KoljaWindeler/CHIP_TZATZIFFY/documentation/solder_SD.png

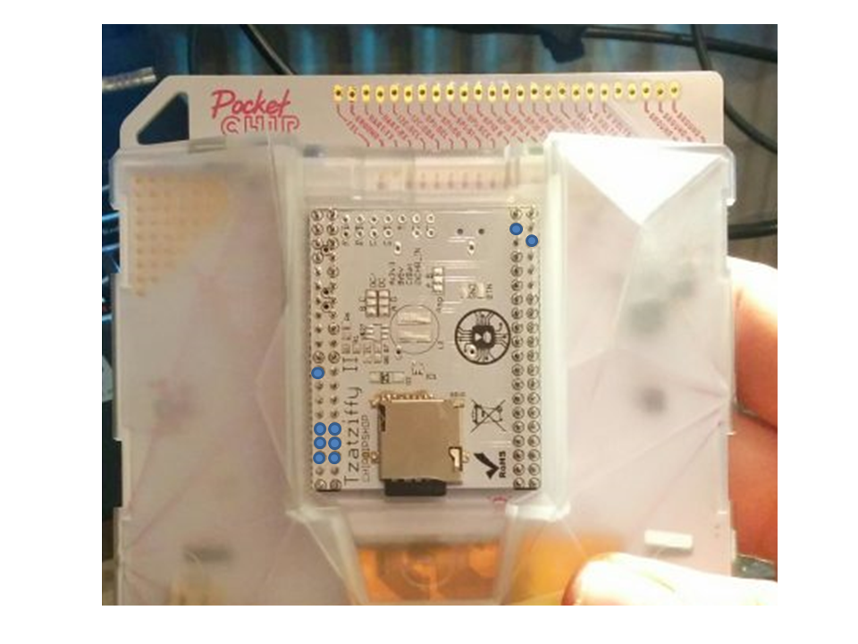
documentation/solder_SD.png
