KoljaWindeler/CHIP_TZATZIFFY/schematic/v6/CHIP_tzatziffy_v6.csv

Part | Value | Device | Package | Description | ASSEMBLE | DESCRIPTION | FOOTPRINT | LINK | MFG | MFG_PN | PART_TYPE | PRICE | TOLLERANCE | VALUE | VENDOR | VENDOR_PART_NUMBER
C1 | 220pF | C-EUC0805 | C0805 | CAPACITOR, European symbol
C2 | 100nF | C-EUC0805 | C0805 | CAPACITOR, European symbol
C3 | 100nF | C-EUC0805 | C0805 | CAPACITOR, European symbol
C4 | 22uF | C-EUC0805 | C0805 | CAPACITOR, European symbol
C5 | 22uF | C-EUC0805 | C0805 | CAPACITOR, European symbol
C6 | 100nF | C-EUC0805 | C0805 | CAPACITOR, European symbol
C7 | n.a. | C-EUC0805 | C0805 | CAPACITOR, European symbol
C8 | 100nF | C-EUC0805 | C0805 | CAPACITOR, European symbol
C9 | 100nF | C-EUC0805 | C0805 | CAPACITOR, European symbol
C10 | n.a. | C-EUC0805 | C0805 | CAPACITOR, European symbol
C11 | 1uF | C-EUC0805 | C0805 | CAPACITOR, European symbol
C12 | 1uF | C-EUC0805 | C0805 | CAPACITOR, European symbol
C13 | 470nF | C-EUC0805 | C0805 | CAPACITOR, European symbol
C14 | 470nF | C-EUC0805 | C0805 | CAPACITOR, European symbol
C15 | 1uF | C-EUC0805 | C0805 | CAPACITOR, European symbol
D1 | B240A | DIODE_SCHTKY_B240 | DO-214AC |  |  | DIODE SMD General Purpose 400V 1A 1.4W RoHS DO-214AC | DO-214AC | http://www.digikey.com/product-detail/en/B240A-13-F/B240A-FDICT-ND/717810 | DIGIKEY | B240A-FDICT-ND | DIODE | 0.11 |  | B240A | DIODES | B240A-13-F
J1 | 2X20-CHIP0.8_DRILL | 2X20-CHIP0.8_DRILL | 2X20CHIP_NOOFFSET-TH_0.8 | Through hole layout with chip reference
J3 | S2B-PH-SM4-TB | S2B-PH-SM4-TB | S2B-PH-SM4-TB |  |  | 2 pin con, 2MM RA, SMD | S2B-PH-SM4-TB | http://www.digikey.com/product-detail/en/S2B-PH-SM4-TB(LF)(SN)/455-1749-1-ND/926846 | DIGIKEY | 455-1749-1-ND | CON | 0.26 |  |  | JST | S2B-PH-SM4-TB(LF)(SN)
L+ | LSP10 | LSP10 | LSP10 | SOLDER PAD drill 1.0 mm, distributor Buerklin, 12H555
L- | LSP10 | LSP10 | LSP10 | SOLDER PAD drill 1.0 mm, distributor Buerklin, 12H555
L1 | SRN6045-100M | SRN6045-100M | SRN6045 |  |  | power inductor 10uH 2.5A 58.6 mohm | SRN6045 | http://www.digikey.com/product-detail/en/SRN6045-100M/SRN6045-100MTR-ND/2756120 | DIGIKEY | SRN6045-100MTR-ND | IND | 0.15 | ±20% |  | BOURNS | SRN6045-100M
L2 | SRN6045-100M | SRN6045-100M | SRN6045 |  |  | power inductor 10uH 2.5A 58.6 mohm | SRN6045 | http://www.digikey.com/product-detail/en/SRN6045-100M/SRN6045-100MTR-ND/2756120 | DIGIKEY | SRN6045-100MTR-ND | IND | 0.15 | ±20% |  | BOURNS | SRN6045-100M
LG | LSP10 | LSP10 | LSP10 | SOLDER PAD drill 1.0 mm, distributor Buerklin, 12H555
LI | LSP10 | LSP10 | LSP10 | SOLDER PAD drill 1.0 mm, distributor Buerklin, 12H555
LO | LSP10 | LSP10 | LSP10 | SOLDER PAD drill 1.0 mm, distributor Buerklin, 12H555
PAM1 |  | PAM8403 | SOP-16 | Dual channel audio amplifier IC - PAM8403
Q1 | NPN-DTC114YUA | NPN-DTC114YUA | SOT323
Q2 | PNP-DTA114YUA | PNP-DTA114YUA | SOT323
R+ | LSP10 | LSP10 | LSP10 | SOLDER PAD drill 1.0 mm, distributor Buerklin, 12H555
R- | LSP10 | LSP10 | LSP10 | SOLDER PAD drill 1.0 mm, distributor Buerklin, 12H555
R1 | 100K | R-EU_M0805 | M0805 | RESISTOR, European symbol
R2 | 31.6k | R-EU_M0805 | M0805 | RESISTOR, European symbol
R3 | 2.21k | R-EU_M0805 | M0805 | RESISTOR, European symbol
R4 | 10k | R-EU_R0805 | R0805 | RESISTOR, European symbol
R5 | 10k | R-EU_R0805 | R0805 | RESISTOR, European symbol
R12 | 4.7K | R-EU_M0805 | M0805 | RESISTOR, European symbol
R13 | 1.2K | R-EU_M0805 | M0805 | RESISTOR, European symbol
RG | LSP10 | LSP10 | LSP10 | SOLDER PAD drill 1.0 mm, distributor Buerklin, 12H555
RI | LSP10 | LSP10 | LSP10 | SOLDER PAD drill 1.0 mm, distributor Buerklin, 12H555
RO | LSP10 | LSP10 | LSP10 | SOLDER PAD drill 1.0 mm, distributor Buerklin, 12H555
SDIO | TF-HOLDER | TF-HOLDER | TF-PULL | TF / Micro SD socket is PUSH-PUSH type, the card can be pushed into and auto locked and pushed out by simply press the card.
SJ1 |  | SOLDERJUMPER_2WAYT | SJ_2 | Solder Jumper
U$2 | LOGO_10X10_SILK | LOGO_10X10_SILK | LOGO2_10X10_SILK
U$3 | LOGO_NO_TRASHROHS | LOGO_NO_TRASHROHS | LOGO_ROHS_SYM
U$4 | LOGO_NO_TRASHNO_TRASH | LOGO_NO_TRASHNO_TRASH | LOGO_ROHS_NO_TRASH
U$5 | LOGO_10X10_SILK | LOGO_10X10_SILK | LOGO2_10X10_SILK
U1 | LMR62421 | LMR62421 | SOT23-5 |  |  | dc/dc step up, 2.1A, 1.6mhz, SOT-23-5 | SOT23-5 | http://www.digikey.com/product-detail/en/LMR62421XMFE%2FNOPB/LMR62421XMFE%2FNOPBCT-ND/2777085 | DIGIKEY | LMR62421XMFE/NOPBCT-ND | IC | 0.8 |  |  | TEXAS INSTRUMENTS | LMR62421XMFE/NOPB
U3 | DS2431P | DS2431P | TSOC6 | 1024-Bit EEPROM |  | IC, 1024-Bit, 1-Wire EEPROM, TSOC6 | TSOC6 | http://www.digikey.com/product-detail/en/DS2431P%2BT%26R/DS2431P%2BT%26RCT-ND/3647900 | DIGIKEY | DS2431P+T&RCT-ND | IC | 0.98 |  |  | MAXIM | DS2431P+T&R
X1 | FH12-40S-0.5SH | FH12-40S-0.5SH | FH12-40S-0.5SH | 0.5mm Pitch Connectors For FPC/FFC |  | CON ffc smd, bottom contact 40pos, 0.50mm R/A | FH12-40S-0.5SH | http://www.digikey.com/product-detail/en/FH12-40S-0.5SH(55)/HFJ140CT-ND/1110388 | DIGIKEY | HFJ140CT-ND |  |  |  |  | HIROSE | FH12-40S-0.5SH(55)
