KoljaWindeler/CHIP_TZATZIFFY/schematic/v9_ordered/CHIP_tzatziffy_v9.pdf

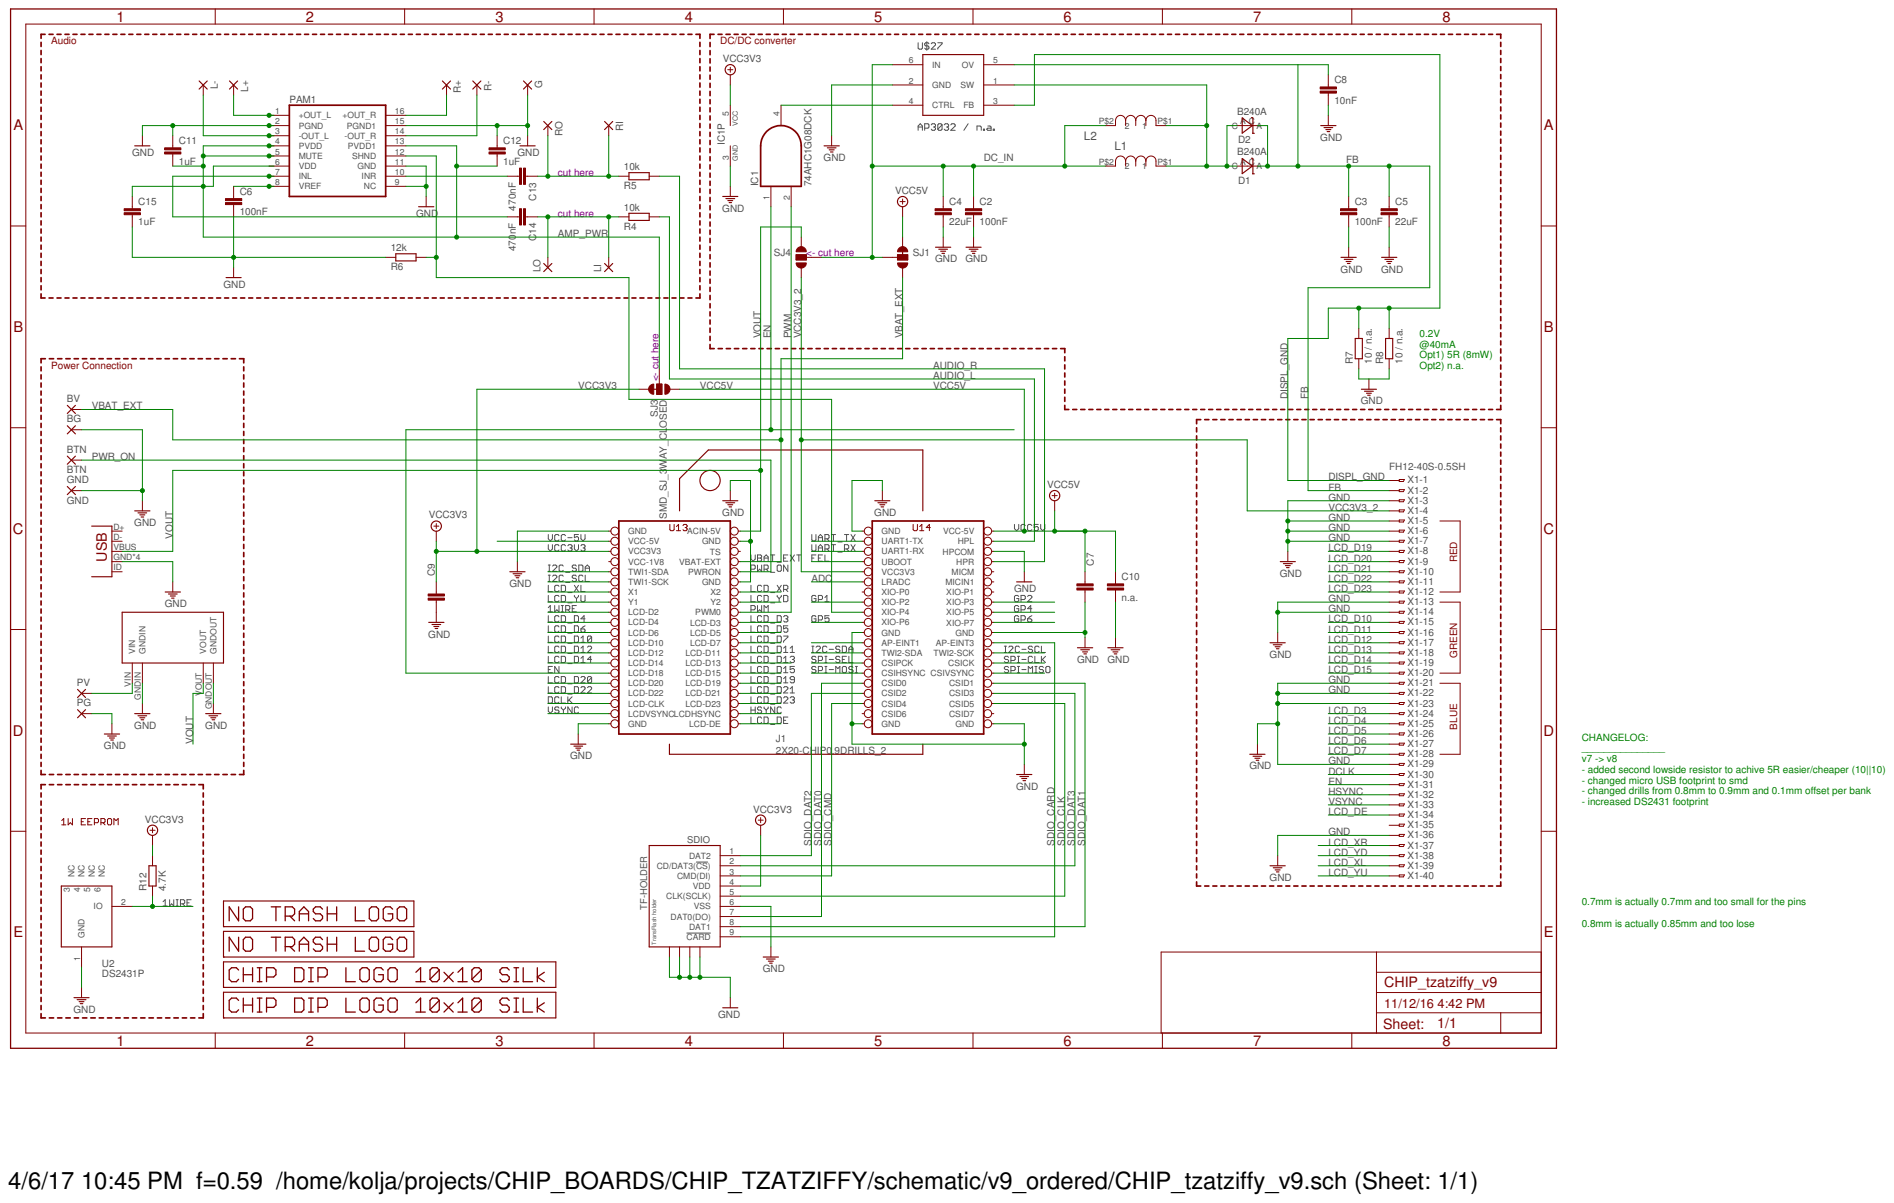
[picture p2: page 1]

<- cut here TransFlash holder

VOUT VOUT GNDOUT GNDOUT

CHANGELOG: _______________
- added second lowside resistor to achive 5R easier/cheaper (10||10)
- changed micro USB footprint to smd
- changed drills from 0.8mm to 0.9mm and 0.1mm offset per bank
- increased DS2431 footprint

0.7mm is actually 0.7mm and too small for the pins 0.8mm is actually 0.85mm and too lose

4/6/17 10:45 PM f=0.59 /home/kolja/projects/CHIP_BOARDS/CHIP_TZATZIFFY/schematic/v9_ordered/CHIP_tzatziffy_v9.sch (Sheet: 1/1)
