KoljaWindeler/CHIP_TZATZIFFY/schematic/v9_ordered/CHIP_tzatziffy_v9_bot.pdf

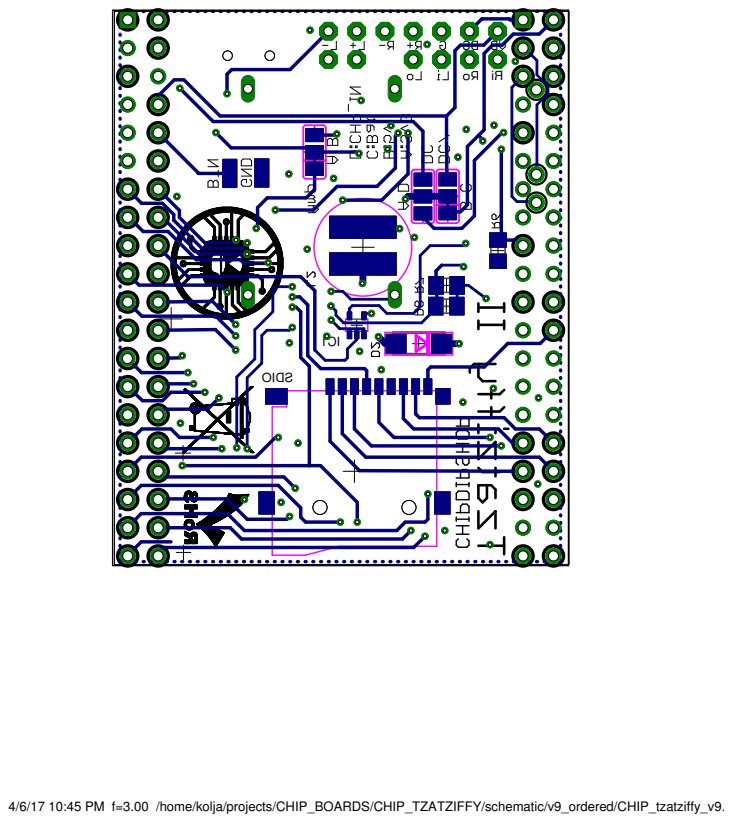
[picture p3: page 1]

4/6/17 10:45 PM f=3.00 /home/kolja/projects/CHIP_BOARDS/CHIP_TZATZIFFY/schematic/v9_ordered/CHIP_tzatziffy_v9.brd
