KoljaWindeler/CHIP_TZATZIFFY/schematic/v9_ordered/CHIP_tzatziffy_v9.brd

## EAGLE design schematic/v9_ordered/CHIP_tzatziffy_v9.brd (2016-11-10)

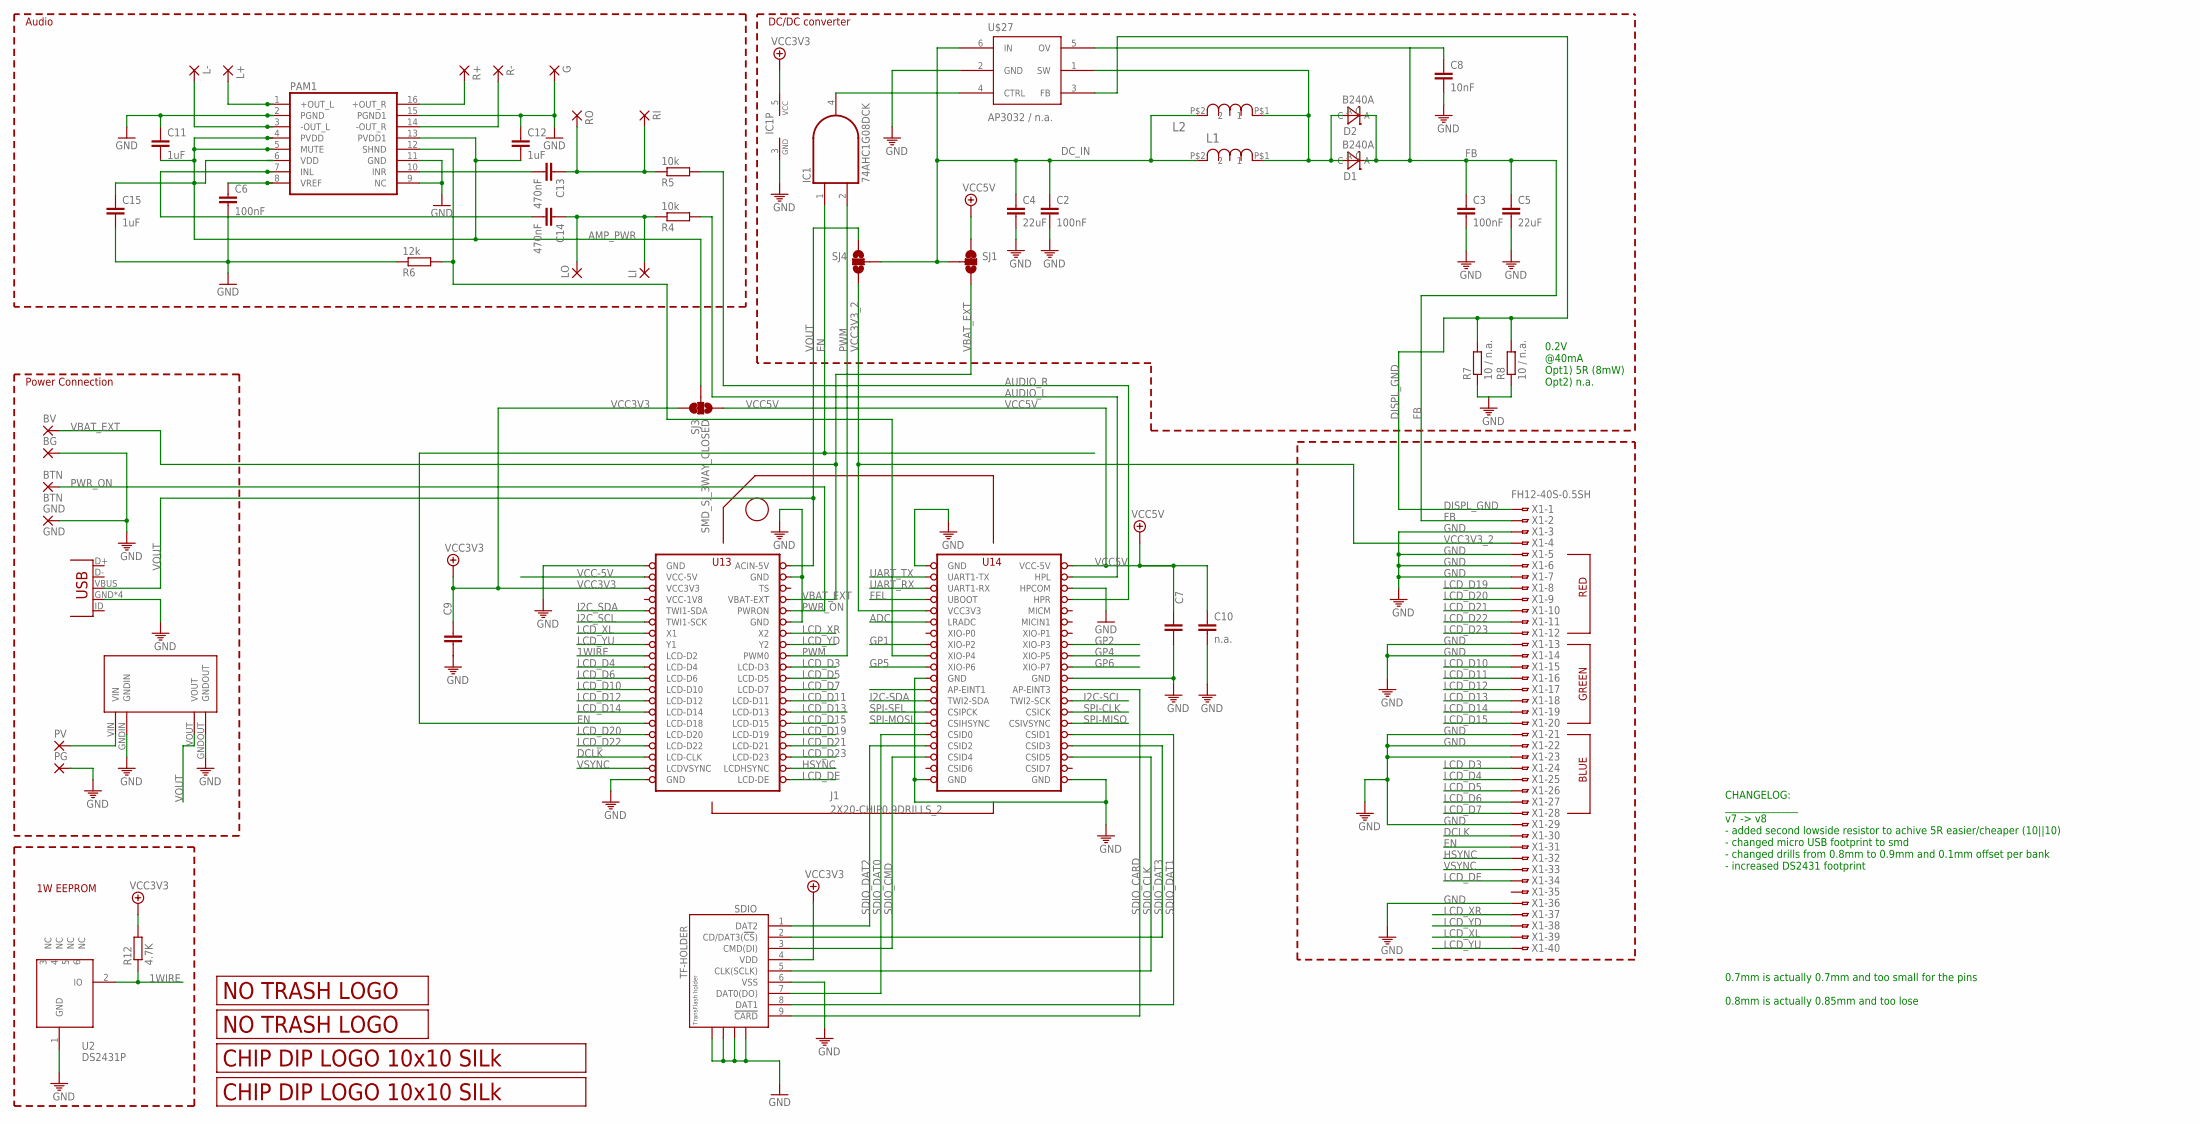
[picture p4: schematic CHIP_tzatziffy_v9.sch]

Parts:
BG: 1,6/0,8
BTN: BTN; SMD1,27-2,54
BV: 1,6/0,8
C2, C3, C6: 100nF; C0805
C4, C5: 22uF; C1206
C7, C9, C10: n.a.; C0805
C8: 10nF; C0805
C11, C12, C15: 1uF; C0805
C13, C14: 470nF; C0805
D1, D2: B240A; DO-214AC
G: 1,6/0,8
GND: GND; SMD1,27-2,54
IC1: 74AHC1G08DCK; SC70-5
J1: 2X20-CHIP0.9DRILLS_2; 2X20CHIP_BANK_OFFSET_TH_0.9
JP1: USBMICRO_SMD; USB-B-MICRO-SMD_V03
L1, L2: SRN6045-100M; SRN6045
L+: 1,6/0,8
L-: 1,6/0,8
LI: 1,6/0,8
LO: 1,6/0,8
PAM1: PAM8403; SOP-16
PG: 1,6/0,8
PV: 1,6/0,8
R4, R5: 10k; R0805
R6: 12k; R0805
R7, R8: 10 / n.a.; M0805
R12: 4.7K; M0805
R+: 1,6/0,8
R-: 1,6/0,8
RI: 1,6/0,8
RO: 1,6/0,8
SDIO: TF-HOLDER; TF-PULL
SJ1, SJ3: SMD_SJ_3WAY_CLOSED
SJ4: SMD_SJ_3WAY_OPENT; SMD_SJ_3WAY_OPEN
U2: DS2431P; TSOC6
U$2, U$5: LOGO_10X10_SILK; LOGO2_10X10_SILK
U$3: LOGO_NO_TRASHROHS; LOGO_ROHS_SYM
U$4: LOGO_NO_TRASHNO_TRASH; LOGO_ROHS_NO_TRASH
U$10: MP1584EN_FRAMELESS
U$27: AP3032 / n.a.; SOT23-6
X1: FH12-40S-0.5SH

Connections:
1WIRE: J1.LCD-D2, R12.1, U2.2 (IO)
ADC: J1.LRADC
AMP_PWR: C11.2, C12.2, C15.1, PAM1.4 (PVDD), PAM1.5 (MUTE), PAM1.6 (VDD), PAM1.13 (PVDD1), SJ3.2
AUDIO_L: J1.HPL, R4.2
AUDIO_R: J1.HPR, R5.2
DCLK: J1.LCD-CLK, X1.30
DC_IN: C2.1, C4.1, L1.P$2 (2), L2.P$2 (2), SJ1.2, SJ4.2, U$27.6 (IN)
DISPL_GND: R7.2, R8.2, U$27.3 (FB), X1.1
EN: IC1.1 (I0), J1.LCD-D18, X1.31
FB: C3.1, C5.1, C8.1, D1.C, D2.C, U$27.5 (OV), X1.2
FEL: J1.FEL (UBOOT)
GND: BG.1, C2.2, C3.2, C4.2, C5.2, C6.2, C7.2, C8.2, C9.2, C10.2, C11.1, C12.1, C15.2, G.1, GND.1, IC1.3 (GND), J1.GND@1 (GND), J1.GND@2 (GND), J1.GND@3 (GND), J1.GND@4 (GND), J1.GND@5 (GND), J1.GND@6 (GND), J1.GND@7 (GND), J1.GND@8 (GND), J1.GND@10 (GND), J1.HPCOM, JP1.GND, JP1.SHIELD1 (GND), JP1.SHIELD2 (GND), JP1.SHIELD3 (GND), PAM1.2 (PGND), PAM1.9 (NC), PAM1.11 (GND), PAM1.15 (PGND1), PG.1, R6.1, R7.1, R8.1, SDIO.6 (VSS), SDIO.S1, SDIO.S2, SDIO.S3, SDIO.S4, U2.1 (GND), U$10.GNDIN, U$10.GNDOUT, U$27.2 (GND), X1.3, X1.5, X1.6, X1.7, X1.13, X1.14, X1.21, X1.22, X1.23, X1.29, X1.36
GP1: J1.XIO-P2
GP2: J1.XIO-P3
GP3: J1.XIO-P4, PAM1.12 (SHND), R6.2
GP4: J1.XIO-P5
GP5: J1.XIO-P6
GP6: J1.XIO-P7
HSYNC: J1.LCD-HSYNC (LCDHSYNC), X1.32
I2C-SCL: J1.TWI2-SCK
I2C-SDA: J1.TWI2-SDA
I2C_SCL: J1.TWI1-SCK
I2C_SDA: J1.TWI1-SDA
INL: C14.2, PAM1.7 (INL)
INR: C13.2, PAM1.10 (INR)
KPD_INT: J1.AP-EINT1
L+OUT: L+.1, PAM1.1 (+OUT_L)
L-OUT: L-.1, PAM1.3 (-OUT_L)
LCD_D3: J1.LCD-D3, X1.24
LCD_D4: J1.LCD-D4, X1.25
LCD_D5: J1.LCD-D5, X1.26
LCD_D6: J1.LCD-D6, X1.27
LCD_D7: J1.LCD-D7, X1.28
LCD_D10: J1.LCD-D10, X1.15
LCD_D11: J1.LCD-D11, X1.16
LCD_D12: J1.LCD-D12, X1.17
LCD_D13: J1.LCD-D13, X1.18
LCD_D14: J1.LCD-D14, X1.19
LCD_D15: J1.LCD-D15, X1.20
LCD_D19: J1.LCD-D19, X1.8
LCD_D20: J1.LCD-D20, X1.9
LCD_D21: J1.LCD-D21, X1.10
LCD_D22: J1.LCD-D22, X1.11
LCD_D23: J1.LCD-D23, X1.12
LCD_DE: J1.LCD-DE, X1.34
LCD_XL: J1.X1, X1.39
LCD_XR: J1.X2, X1.37
LCD_YD: J1.Y2, X1.38
LCD_YU: J1.Y1, X1.40
unnamed: IC1.4 (O), U$27.4 (CTRL)
unnamed: C6.1, PAM1.8 (VREF)
unnamed: C14.1, LI.1, LO.1, R4.1
unnamed: C13.1, R5.1, RI.1, RO.1
PWM: IC1.2 (I1), J1.PWM0
PWR_IN: PV.1, U$10.VIN
PWR_ON: BTN.1, J1.PWRON
R+OUT: PAM1.16 (+OUT_R), R+.1
R-OUT: PAM1.14 (-OUT_R), R-.1
SDIO_CARD: J1.AP-EINT3, SDIO.9 (!CARD)
SDIO_CLK: J1.CSID5, SDIO.5 (CLK(SCLK))
SDIO_CMD: J1.CSID4, SDIO.3 (CMD(DI))
SDIO_DAT0: J1.CSID0, SDIO.7 (DAT0(DO))
SDIO_DAT1: J1.CSID1, SDIO.8 (DAT1)
SDIO_DAT2: J1.CSID2, SDIO.1 (DAT2)
SDIO_DAT3: J1.CSID3, SDIO.2 (CD/DAT3(!CS!))
SPI-CLK: J1.CSICK
SPI-MISO: J1.CSIVSYNC
SPI-MOSI: J1.CSIHSYNC
SPI-SEL: J1.CSIPCK
UART_RX: J1.UART1-RX
UART_TX: J1.UART1-TX
VBAT_EXT: BV.1, J1.BAT (VBAT-EXT), SJ1.3
VCC3V3: C9.1, IC1.5 (VCC), J1.VCC3V3, R12.2, SDIO.4 (VDD), SJ3.1
VCC3V3_2: J1.VCC3V3@1 (VCC3V3), SJ4.3, X1.4
VCC5V: C7.1, C10.1, J1.VCC5V@1 (VCC-5V), SJ1.1, SJ3.3
VCC-1V8: J1.VCC1V8 (VCC-1V8)
VCC-5V: J1.VCC5V@0 (VCC-5V)
VOUT: J1.CHG-IN (ACIN-5V), JP1.VBUS, SJ4.1, U$10.VOUT
VREG_OUTPUT: D1.A, D2.A, L1.P$1 (1), L2.P$1 (1), U$27.1 (SW)
VSYNC: J1.LCD-VSYNC (LCDVSYNC), X1.33

Notes on the sheet:
RED
GREEN
BLUE
Power Connection
1W EEPROM
Audio
DC/DC converter
0.2V @40mA Opt1) 5R (8mW) Opt2) n.a.
0.7mm is actually 0.7mm and too small for the pins 0.8mm is actually 0.85mm and too lose
CHANGELOG: _______________ v7 -> v8 - added second lowside resistor to achive 5R easier/cheaper (10||10) - changed micro USB footprint to smd - changed drills from 0.8mm to 0.9mm and 0.1mm offset per bank - increased DS2431 footprint

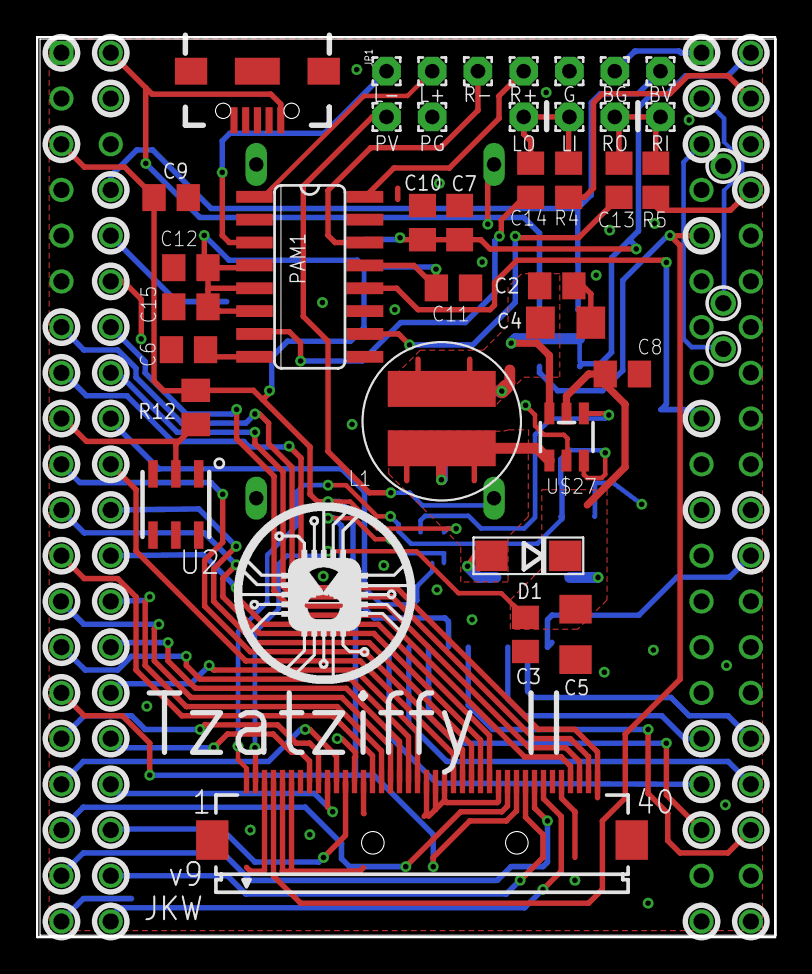
[picture p5: board CHIP_tzatziffy_v9.brd from above]

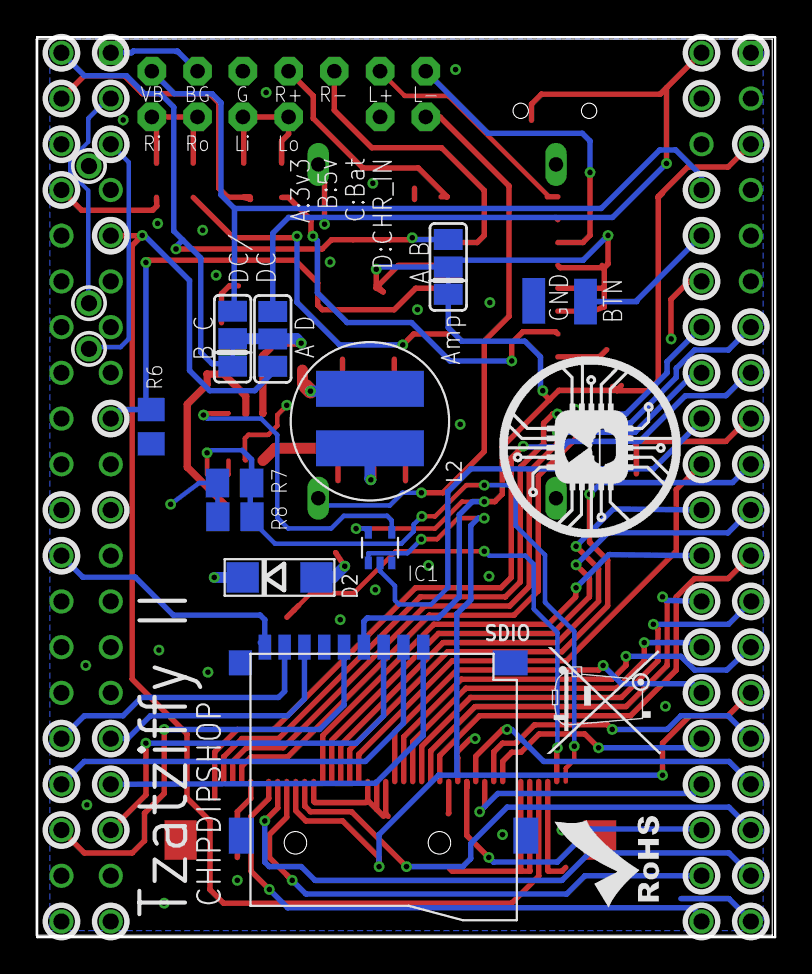
[picture p6: board CHIP_tzatziffy_v9.brd from below]

Board: 2 copper layers, 41.0 x 50.0 mm, 55 parts (15 on the bottom side), 60 nets.
