KoljaWindeler/CHIP_TZATZIFFY/documentation/solder_SD.pptx

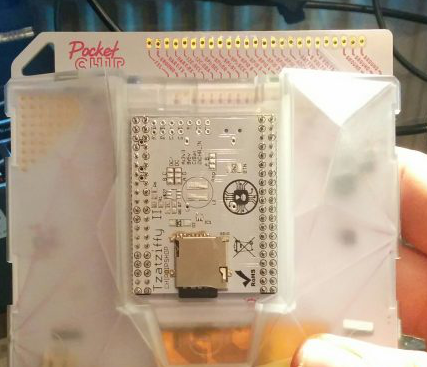
[picture p7: figure]
