KoljaWindeler/CHIP_TZATZIFFY/(commit log)

2016-08-28 added solder marks
    [CHIP_dispv2.0.brd]
2016-08-28 moved sd to right
    [CHIP_dispv2.0.brd]
2016-08-29 added v3 incl gerber
    [CHIP_dispv3.0.brd, CHIP_dispv3.0.sch]
2016-08-29 recalc resistor to generate 19.2V
    [CHIP_dispv3.0.brd, CHIP_dispv3.0.sch]
2016-09-02 added v4, with battery to 5v switch
    [CHIP_ziffy_v4.brd, CHIP_ziffy_v4.sch]
2016-09-08 added v5 with correct mute potential
    [CHIP_ziffy_v5.brd, CHIP_ziffy_v5.sch]
2016-09-15 Optimized routing, added symbols
    [CHIP_tzatziffy_v6.GBL, CHIP_tzatziffy_v6.GBO, CHIP_tzatziffy_v6.GBP, CHIP_tzatziffy_v6.GBS, CHIP_tzatziffy_v6.GTL, CHIP_tzatziffy_v6.GTO, CHIP_tzatziffy_v6.GTP, CHIP_tzatziffy_v6.GTS]
2016-09-15 moved v5 to ordered_v5
    [CHIP_ziffy_v5.brd, CHIP_ziffy_v5.sch]
2016-09-15 added diode on bottom
    [CHIP_tzatziffy_v6.brd, CHIP_tzatziffy_v6.sch]
2016-09-16 added elecrow rulecheck and fixed details
    [CHIP_tzatziffy_v6.brd]
2016-09-18 Added connection for poti
    [CHIP_tzatziffy_v6.brd, CHIP_tzatziffy_v6.sch]
2016-09-18 added pulldown for shutdown
    [CHIP_tzatziffy_v6.brd, CHIP_tzatziffy_v6.sch]
2016-09-18 added note for pulldown
    [CHIP_tzatziffy_v6.sch]
2016-09-18 changed pulldown to assembled
    [CHIP_tzatziffy_v6.brd, CHIP_tzatziffy_v6.sch]
2016-09-21 added note for correct voltage divider
    [CHIP_tzatziffy_v6.sch]
2016-09-21 added datasheets
    [CHIP_tzatziffy_v6.csv, CHIP_tzatziffy_v6.ods]
2016-09-22 changed 22uF Footprint to 1206
    [CHIP_tzatziffy_v6.brd, CHIP_tzatziffy_v6.sch]
2016-09-23 Adding scripts and quote
    [CHIP_tzatziffy_v6.brd, CHIP_tzatziffy_v6.csv, CHIP_tzatziffy_v6.ods, quotation_assumtions.xlsx]
2016-09-26 Added pads for power button and vias for the uart header
    [CHIP_tzatziffy_v6.brd, CHIP_tzatziffy_v6.sch]
2016-09-26 added orange text and removed frame
2016-09-28 changed poti pins to smaller restring, added jumper for 3.3/5/vbat for DC/DC and 3.3/5 for audio amp
    [CHIP_tzatziffy_v6.brd, CHIP_tzatziffy_v6.sch]
2016-09-29 replaced bipolar with mosfet circuit and relayouted
    [CHIP_tzatziffy_v6.brd, CHIP_tzatziffy_v6.sch]
2016-09-30 simplyfied the backlight driver ... a lot
    [CHIP_tzatziffy_v6.brd, CHIP_tzatziffy_v6.sch]
2016-09-30 added adafruit 10v datasheet
2016-09-30 changed holes size to 0.7mm
    [CHIP_tzatziffy_v6.brd, CHIP_tzatziffy_v6.sch]
2016-09-30 moved silkscreen label
    [CHIP_tzatziffy_v6.brd]
2016-09-30 updated gerber
    [CHIP_tzatziffy_v6.brd]
2016-09-30 removed old gerber
    [CHIP_tzatziffy_v6.GBL, CHIP_tzatziffy_v6.GBO, CHIP_tzatziffy_v6.GBP, CHIP_tzatziffy_v6.GBS, CHIP_tzatziffy_v6.GTL, CHIP_tzatziffy_v6.GTO, CHIP_tzatziffy_v6.GTP, CHIP_tzatziffy_v6.GTS]
2016-09-30 renamed v6 to ordered
    [CHIP_tzatziffy_v6.brd, CHIP_tzatziffy_v6.sch]
2016-10-06 added micro usb port
    [CHIP_tzatziffy_v7.brd, CHIP_tzatziffy_v7.sch]
2016-10-07 improved routing
    [CHIP_tzatziffy_v7.brd, CHIP_tzatziffy_v7.sch]
2016-10-07 added power supply
    [CHIP_tzatziffy_v7.brd, CHIP_tzatziffy_v7.sch]
2016-10-07 optimized routing
    [CHIP_tzatziffy_v7.brd]
2016-10-07 optimized routing and schematic
    [CHIP_tzatziffy_v7.brd, CHIP_tzatziffy_v7.sch]
2016-10-08 added print photo info and optimized search a lot!
2016-10-09 added dc/dc alternate switch
2016-10-09 added alternate dc/dc switch
    [CHIP_tzatziffy_v7.brd, CHIP_tzatziffy_v7.sch]
2016-10-09 fixed airwire
    [CHIP_tzatziffy_v7.brd]
2016-10-11 moved to ordered
    [CHIP_tzatziffy_v7.brd, CHIP_tzatziffy_v7.sch]
2016-10-13 added v8 with quotation, only added second resistor footprint to ease up the R||R combination e.g. to achive 5R as 10R || 10R
    [CHIP_tzatziffy_v6.csv, CHIP_tzatziffy_v8.brd, CHIP_tzatziffy_v8.sch, bom_template_2016-08-18.csv, quotation_assumtions.xlsx]
2016-10-14 updated quote v8
    [CHIP_tzatziffy_v6.csv, bom_template_2016-08-18.csv, quotation_assumtions.xlsx, tzatziffy_v8.xls]
2016-10-17 .\quotations\v8\PCBA_with_elecrow_quotation_tzatziffy_v8.xlsx
    updated elecrow quote
    [PCBA_with_elecrow_quotation_tzatziffy_v8.xlsx]
2016-10-17 added prices for 0 count parts
    [PCBA_with_elecrow_quotation_tzatziffy_v8.xlsx]
2016-10-18 added usb jack to quote
    [PCBA_with_elecrow_quotation_tzatziffy_v8.xlsx]
2016-10-18 use of new usb lib
    [CHIP_tzatziffy_v8.brd, CHIP_tzatziffy_v8.sch]
2016-10-18 changed 22uF cap to 1210
    [PCBA_with_elecrow_quotation_tzatziffy_v8.xlsx]
2016-10-19 updated cost for 22uF
    [PCBA_with_elecrow_quotation_tzatziffy_v8.xlsx]
2016-10-19 added new smd usb
    [CHIP_tzatziffy_v8.brd, CHIP_tzatziffy_v8.sch, PCBA_with_elecrow_quotation_tzatziffy_v8.xlsx]
2016-10-20 updated smd usb jack
    [PCBA_with_elecrow_quotation_tzatziffy_v8.xlsx]
2016-10-25 changed chip footprint to clamp via row claming 0.1mm outside and ordered v8
    [CHIP_tzatziffy_v8.brd, CHIP_tzatziffy_v8.sch]
2016-10-25 added and gate
    [CHIP_tzatziffy_v8.brd, CHIP_tzatziffy_v8.sch]
2016-10-27 inverted PWM
2016-10-27 working dtc compiler and pwm
2016-10-29 display switch script
2016-11-02 added psp screen modification drawing
    [v8_psp.brd, v8_psp.sch]
2016-11-09 removed psp schematic, see separate respo
    [v8_psp.brd, v8_psp.sch]
2016-11-10 added version9, working fine, ready for production
    [CHIP_tzatziffy_v9.brd, CHIP_tzatziffy_v9.sch, PCBA_with_elecrow_quotation_tzatziffy_v9.xlsx]
2016-12-08 replaced quote
    [PCBA_with_elecrow_quotation_tzatziffy_v9.xlsx, tzatziffy_v9_V6.xlsx]
2016-12-08 added solder docu
2017-04-18 added v7
    [tzatziffy_v9_V6.xlsx, tzatziffy_v9_V7.xlsx]
