KoljaWindeler/CHIP_TZATZIFFY/(notices)

Notices in the files:
parts and their libraries:
SparkFun-Retired: Licensing:Creative Commons ShareAlike 4.0 International - https://creativecommons.org/licenses/by-sa/4.0
JKW_CHIP: License : http://creativecommons.org/licenses/by-sa/3.0
(Creative Commons 3.0)
